zevv/phonectl/pcb/step/ec12e24204a8.stp

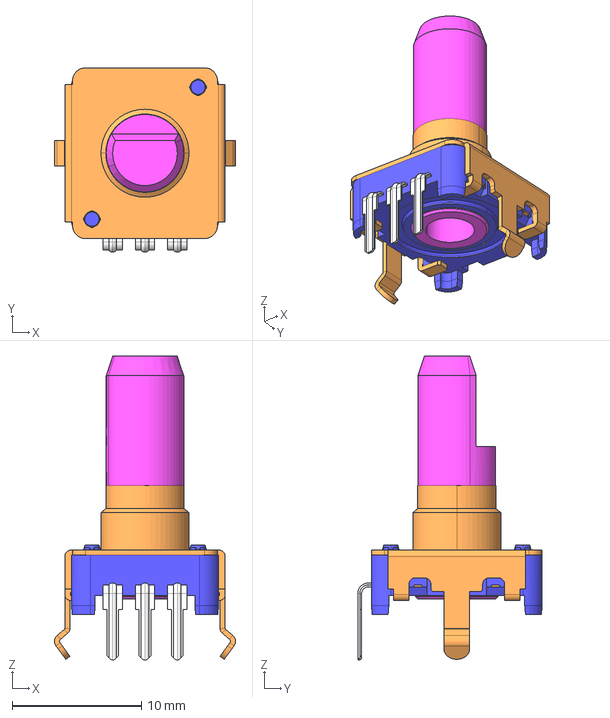
[picture p1: CAD file, 2024-02-28]
pcb/step/ec12e24204a8.stp
14.0 x 14.2 x 23.5 mm
