zevv/phonectl/pcb/step/105450-0101--3DModel-STEP-56544.STEP

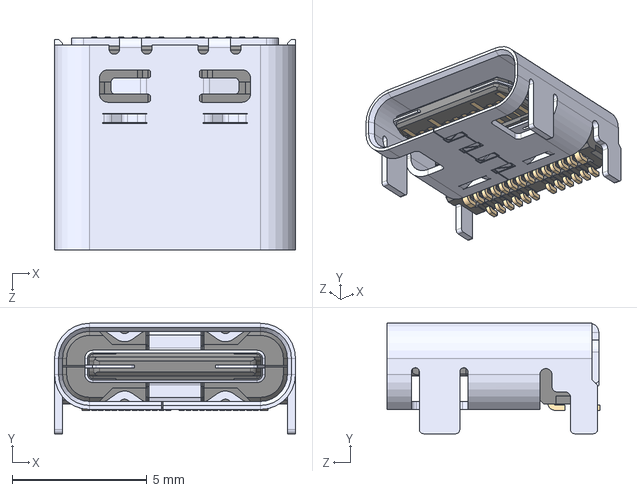
[picture p2: CAD file, 2024-02-28]
pcb/step/105450-0101--3DModel-STEP-56544.STEP
8.94 x 4.10 x 7.90 mm
