zevv/phonectl/pcb/bedside-phone-control.kicad_pcb

## KiCad design pcb/bedside-phone-control.kicad_pcb (2024-03-21)

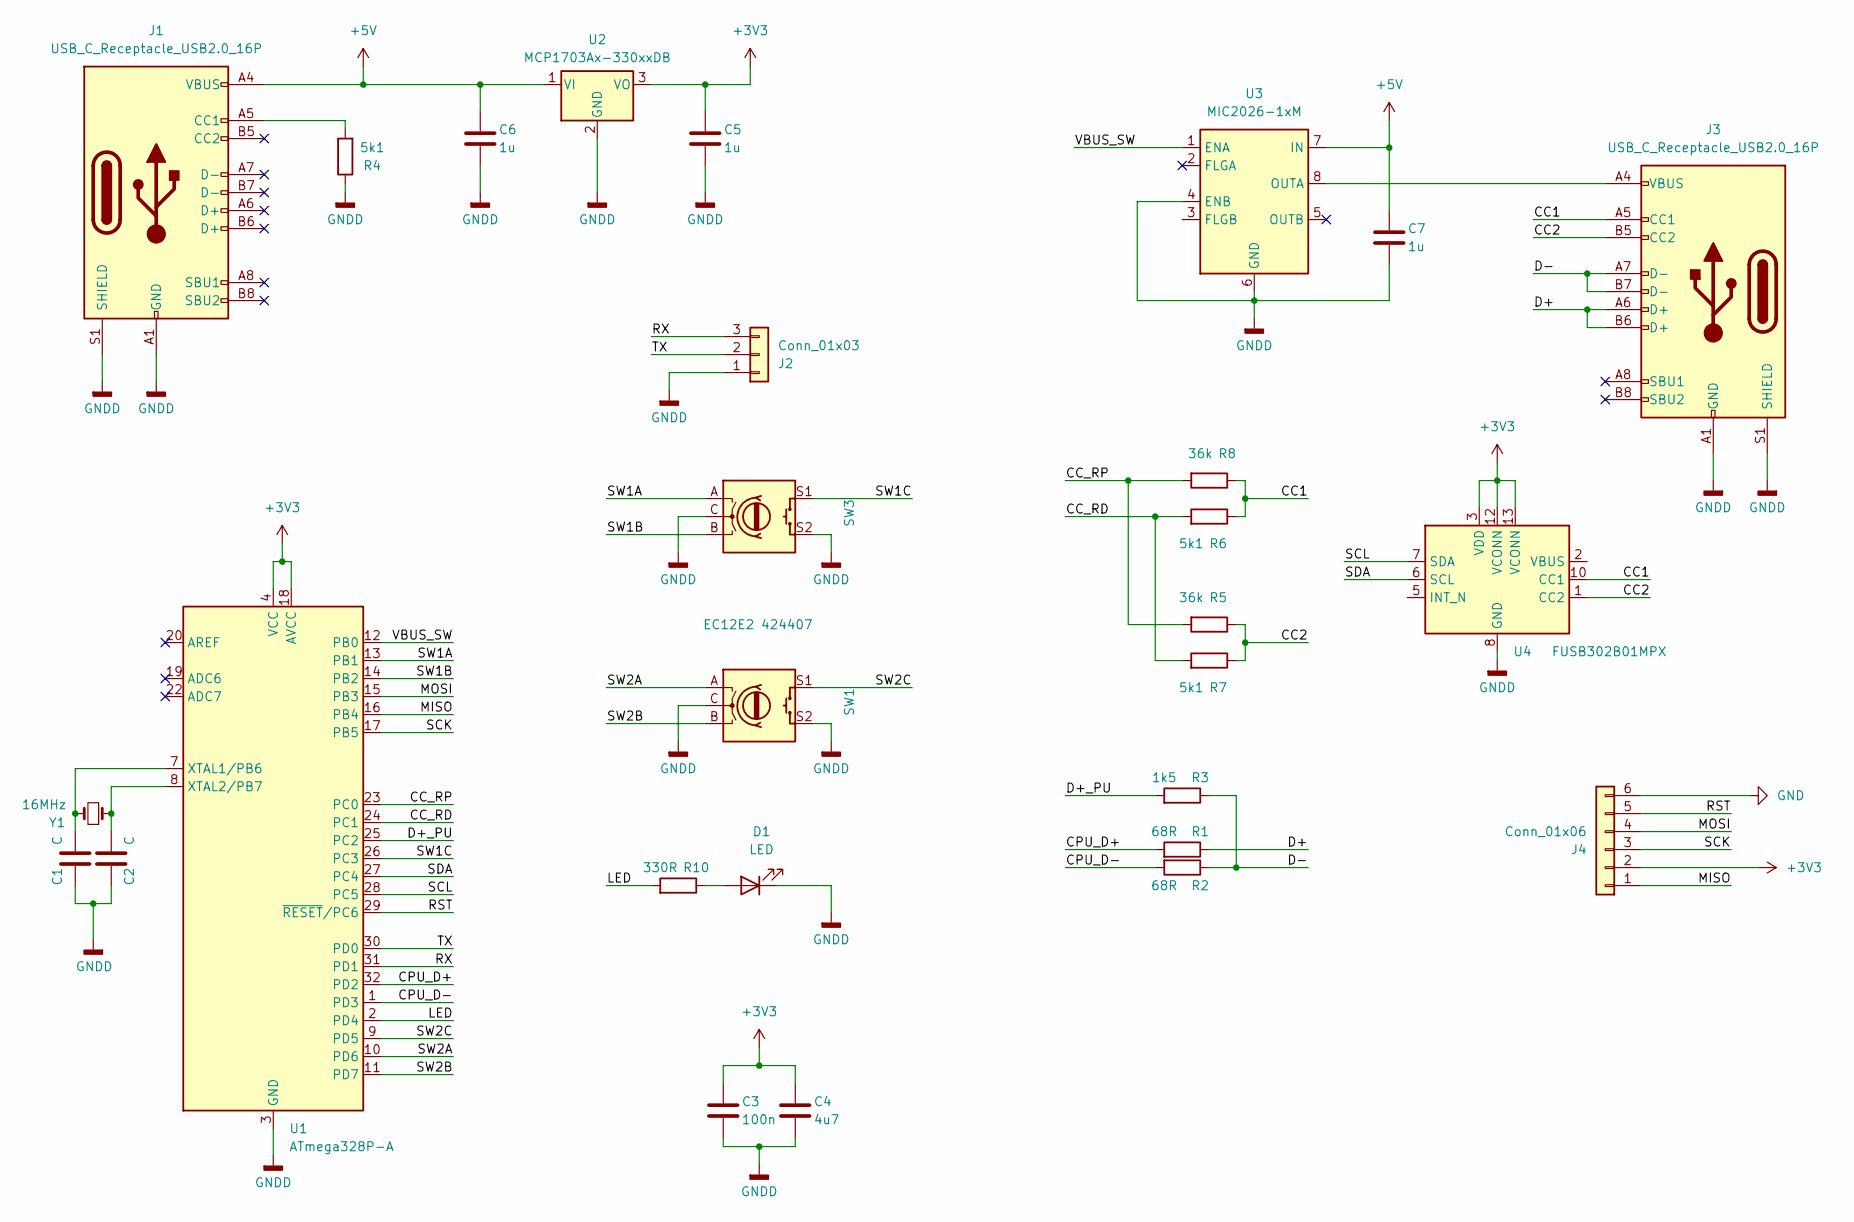
[picture p3: schematic bedside-phone-control.kicad_sch, phonectl]

Parts:
C1, C2: C; C_0603_1608Metric
C3: 100n; C_0603_1608Metric
C4: 4u7; C_0603_1608Metric
C5, C6, C7: 1u; C_0603_1608Metric
D1: LED; LED_D3.0mm
J1, J3: USB_C_Receptacle_USB2.0_16P; USB_C_Receptacle_Molex_105450-0101
J2: Conn_01x03; PinHeader_1x03_P2.54mm_Vertical
J4: Conn_01x06; PinHeader_2x03_P2.54mm_Vertical
R1, R2: 68R; R_0603_1608Metric
R3: 1k5; R_0603_1608Metric
R4, R6, R7: 5k1; R_0603_1608Metric
R5, R8: 36k; R_0603_1608Metric
R10: 330R; R_0603_1608Metric
SW1: RotaryEncoder_Switch; RotaryEncoder_Alps_EC11E-Switch_Vertical_H20mm
SW3: EC12E2 424407; RotaryEncoder_Alps_EC11E-Switch_Vertical_H20mm
U1: ATmega328P-A; TQFP-32_7x7mm_P0.8mm
U2: MCP1703Ax-330xxDB; SOT-223-3_TabPin2
U3: MIC2026-1xM; SOIC-8_3.9x4.9mm_P1.27mm
U4: FUSB302B01MPX; WQFN-14-1EP_2.5x2.5mm_P0.5mm_EP1.45x1.45mm
Y1: 16MHz; Crystal_SMD_Abracon_ABM3-2Pin_5.0x3.2mm_HandSoldering

Connections:
+3V3: C3.2, C4.2, C5.2, J4.2, U1.4 (VCC), U1.6 (VCC), U1.18 (AVCC), U2.3 (VO), U4.3 (VDD), U4.4 (VDD), U4.12 (VCONN), U4.13 (VCONN)
+5V: C6.2, C7.2, J1.A4 (VBUS), J1.A9 (VBUS), J1.B4 (VBUS), J1.B9 (VBUS), U2.1 (VI), U3.7 (IN)
/CC1: J3.A5 (CC1), R6.1, R8.1, U4.10 (CC1), U4.11 (CC1)
/CC2: J3.B5 (CC2), R5.1, R7.1, U4.1 (CC2), U4.14 (CC2)
/CC_RD: R6.2, R7.2, U1.24 (PC1)
/CC_RP: R5.2, R8.2, U1.23 (PC0)
/CPU_D+: R1.2, U1.32 (PD2)
/CPU_D-: R2.2, U1.1 (PD3)
/D+: J3.A6 (D+), J3.B6 (D+), R1.1
/D+_PU: R3.2, U1.25 (PC2)
/D-: J3.A7 (D-), J3.B7 (D-), R2.1, R3.1
/LED: R10.2, U1.2 (PD4)
/MISO: J4.1, U1.16 (PB4)
/MOSI: J4.4, U1.15 (PB3)
/RST: J4.5, U1.29 (~RESET/PC6)
/RX: J2.3, U1.31 (PD1)
/SCK: J4.3, U1.17 (PB5)
/SCL: U1.28 (PC5), U4.7 (SDA)
/SDA: U1.27 (PC4), U4.6 (SCL)
/SW1A: SW3.A, U1.13 (PB1)
/SW1B: SW3.B, U1.14 (PB2)
/SW1C: SW3.S1, U1.26 (PC3)
/SW2A: SW1.A, U1.10 (PD6)
/SW2B: SW1.B, U1.11 (PD7)
/SW2C: SW1.S1, U1.9 (PD5)
/TX: J2.2, U1.30 (PD0)
/VBUS_SW: U1.12 (PB0), U3.1 (ENA)
GND: J4.6
GNDD: C1.2, C2.2, C3.1, C4.1, C5.1, C6.1, C7.1, D1.1 (K), J1.A1 (GND), J1.A12 (GND), J1.B1 (GND), J1.B12 (GND), J1.S1 (SHIELD), J2.1, J3.A1 (GND), J3.A12 (GND), J3.B1 (GND), J3.B12 (GND), J3.S1 (SHIELD), R4.1, SW1.C, SW1.S2, SW3.C, SW3.S2, U1.3 (GND), U1.5 (GND), U1.21 (GND), U2.2 (GND), U3.4 (ENB), U3.6 (GND), U4.8 (GND), U4.9 (GND), U4.15 (GND)
unnamed: D1.2 (A), R10.1
unnamed: J1.A5 (CC1), R4.2
unnamed: C1.1, U1.7 (XTAL1/PB6), Y1.2
unnamed: C2.1, U1.8 (XTAL2/PB7), Y1.1
unnamed: J3.A4 (VBUS), J3.A9 (VBUS), J3.B4 (VBUS), J3.B9 (VBUS), U3.8 (OUTA)

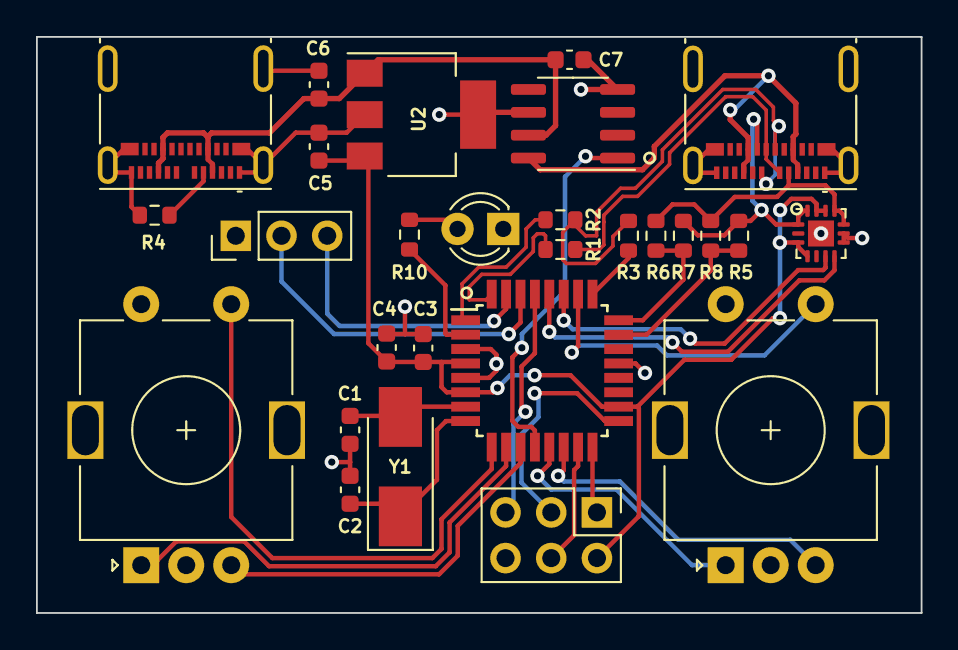
[picture p4: board bedside-phone-control.kicad_pcb from above]

Board: 2 copper layers, 49.1 x 32.0 mm, 28 parts (0 on the bottom side), 33 nets.
