zevv/phonectl/src/button.h

#ifndef button_h
#define button_h

enum button_id {
	BUTTON_ID_L_CW,
	BUTTON_ID_L_CCW,
	BUTTON_ID_L_PUSH,
	BUTTON_ID_R_CW,
	BUTTON_ID_R_CCW,
	BUTTON_ID_R_PUSH,
};

void button_init();
void button_poll();

#endif
