zevv/phonectl/(commit log)

2024-02-28 more checkin
    [105450-0101--3DModel-STEP-56544.STEP, bedside-phone-control.kicad_pcb, bedside-phone-control.kicad_sch, ec12e24204a8.stp]
2024-03-21 getting there
    [bedside-phone-control.kicad_pcb, bedside-phone-control.kicad_sch]
